dingyiyi0226/Wearable-Torjan-Radar-System/README.md

# Wearable Trojan Radar System

2020 IEEE AP-S Student Design Contest - Team Troy

## How to use

1. Build up the system with the [instruction](Instruction.pdf)

2. Edit the pin setting in `config.py`

3. Run main process

    ```
    python3 main_control.py
    ```

## Links
-  [SDC site](https://2020apsursi.org/StudentDesignContest.asp)
-  [Final report](https://resourcecenter.ieeeaps.org/conferences/2020-ap-symposium/APS2020SYMFIN0160.html)
-  [Demo video](https://youtu.be/o_KWvV_8DFA)
