dingyiyi0226/Wearable-Torjan-Radar-System/layout/5.8GHz Circuits_Bottom (RO4003C 20mil).pdf

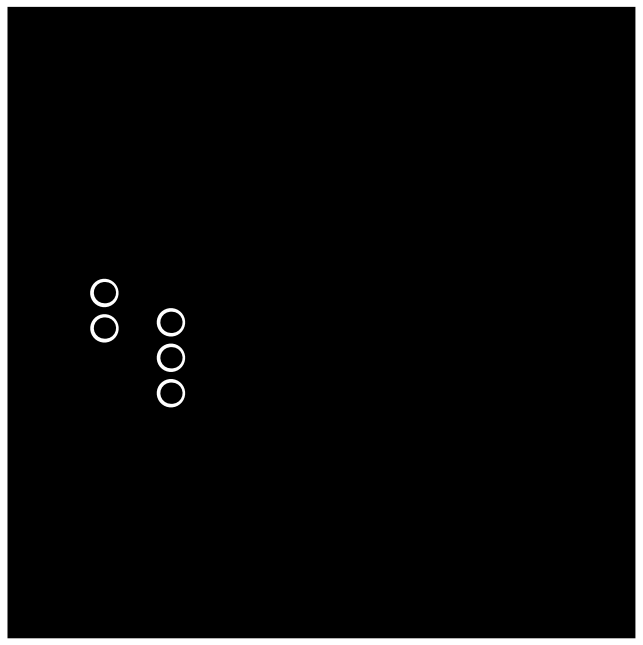
[picture p1: figure]
