dingyiyi0226/Wearable-Torjan-Radar-System/layout/5.8GHz Circuits_Top (RO4003C 20mil).pdf

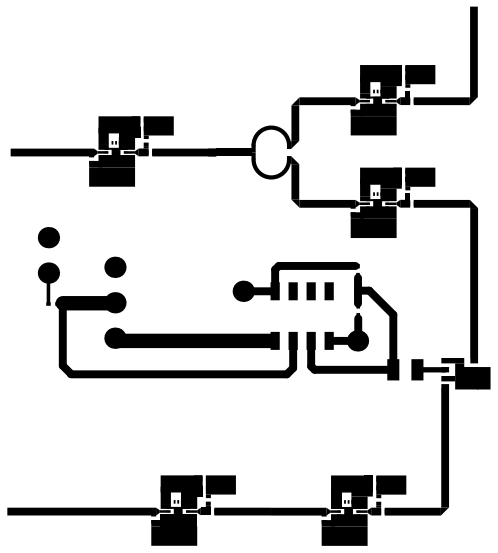
[picture p2: figure]
