dingyiyi0226/Wearable-Torjan-Radar-System/layout/915MHz Circuits_Bottom (RO4003C 20mil).pdf

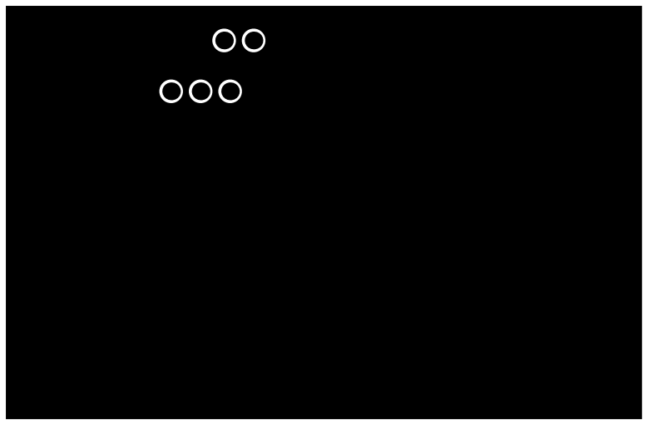
[picture p3: figure]
