dingyiyi0226/Wearable-Torjan-Radar-System/layout/915MHz Circuits_Top (RO4003C 20mil).pdf

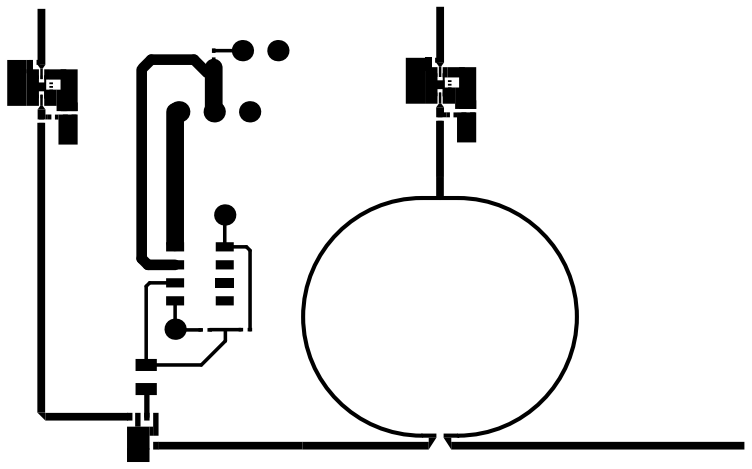
[picture p4: figure]
