dingyiyi0226/Wearable-Torjan-Radar-System/ADC/config.py

# /*****************************************************************************
# * | File        :	  EPD_1in54.py
# * | Author      :   Waveshare team
# * | Function    :   Hardware underlying interface
# * | Info        :
# *----------------
# * |	This version:   V1.0
# * | Date        :   2019-01-24
# * | Info        :   
# ******************************************************************************/
# Permission is hereby granted, free of charge, to any person obtaining a copy
# of this software and associated documnetation files (the "Software"), to deal
# in the Software without restriction, including without limitation the rights
# to use, copy, modify, merge, publish, distribute, sublicense, and/or sell
# copies of the Software, and to permit persons to  whom the Software is
# furished to do so, subject to the following conditions:
#
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


import spidev
import RPi.GPIO as GPIO
import time

# ----------------------------------------------------- #
# Pin declaration (BCM / BOARD)                         # 
# ===================================================== #
# RST_PIN     = 18 / 12                                 #
# CS_PIN      = 22 / 15                                 #
# CS_DAC_PIN  = 23 / 16                                 #
# DRDY_PIN    = 17 / 11                                 #
# ----------------------------------------------------- #

RST_PIN     = 5
CS_PIN      = 7
DRDY_PIN    = 3
# CS_DAC_PIN  = 16

# SPI device, bus = 0, device = 0
SPI = spidev.SpiDev(0, 0)

def digital_write(pin, value):
    GPIO.output(pin, value)

def digital_read(pin):
    return GPIO.input(DRDY_PIN)

def delay_ms(delaytime):
    time.sleep(delaytime // 1000.0)

def spi_writebyte(data):
    SPI.writebytes(data)
    
def spi_readbytes(reg):
    return SPI.readbytes(reg)

def module_init():
    GPIO.setmode(GPIO.BOARD)
    GPIO.setwarnings(False)

    GPIO.setup(RST_PIN, GPIO.OUT)
    # GPIO.setup(CS_DAC_PIN, GPIO.OUT)
    GPIO.setup(CS_PIN, GPIO.OUT)
    GPIO.setup(DRDY_PIN, GPIO.IN, pull_up_down=GPIO.PUD_UP)
    
    SPI.max_speed_hz = 3840000
    SPI.mode = 0b01

    return 0

### END OF FILE ###
