dingyiyi0226/Wearable-Torjan-Radar-System/sigGen/src/main/main.cpp

/*
 * SPI testing utility (using spidev driver)
 *
 * Copyright (c) 2007  MontaVista Software, Inc.
 * Copyright (c) 2007  Anton Vorontsov <avorontsov@ru.mvista.com>
 *
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
 * Cross-compile with cross-gcc -I/path/to/cross-kernel/include
 */

#include <stdint.h>
#include <unistd.h>
#include <stdio.h>
#include <stdlib.h>
#include <getopt.h>
#include <fcntl.h>
#include <sys/ioctl.h>
#include <linux/types.h>
#include <linux/spi/spidev.h>

#include <bcm2835.h>
#include "gpio.h"
#include "sysfs.h"

#define POUT 23 /* P1-16 */

#define ARRAY_SIZE(a) (sizeof(a) / sizeof((a)[0]))

static uint8_t tx[5]  = { 0xF0, 0xF0, 0xF0, 0xF0, 0xF0 };
static uint8_t tx2[5] = { 0xCC, 0xCC, 0xCC, 0xCC, 0xCC };
static char tx3[5]    = { 0xF0, 0xF0, 0xF0, 0xF0, 0xF0 };
static char tx4[5]    = { 0xCC, 0xCC, 0xCC, 0xCC, 0xCC };
static uint8_t rx[ARRAY_SIZE(tx)]   = {0, };

static void
Dec2Hex(uint8_t *value, int dec)
{
    // TODO 
}

static void
getControlWord(int freq, int phase)
{
    // TODO
}

static void
Dec2Bin(char* value, int dec)
{
    // TODO
    int count = 0;

    for (int c = 31; c > 0; --c)
    {
        *(value + count) = ((dec >> c) & 1)? 1 + '0': 0 + '0';
        ++count;
    }

    *(value + count) = 0 + '\0';
}

int
main(int argc, char **argv)
{
    // Setup SPI pins
    if (!bcm2835_init() || !bcm2835_spi_begin())
    {
        printf("BCM2835 SPI Begin failure, please try with sudo\n");
        return EXIT_SUCCESS;
    }

    // Set SPI MSB First
    bcm2835_spi_setBitOrder(BCM2835_SPI_BIT_ORDER_MSBFIRST);

    // Set CHIP (CS0 (19, 21, 23) or CS1)
    bcm2835_spi_chipSelect(BCM2835_SPI_CS0);

    // Set CS pins polarity to low
    bcm2835_spi_setChipSelectPolarity(BCM2835_SPI_CS0, 0);
    bcm2835_spi_setChipSelectPolarity(BCM2835_SPI_CS1, 0);
    
    // Set SPI clock speed 
    // Notes: In RPi2, CDIV4 and CDIV2 mode are unstable.
    bcm2835_spi_setClockDivider(BCM2835_SPI_CLOCK_DIVIDER_2);

    // Set SPI data mode
    bcm2835_spi_setDataMode(BCM2835_SPI_MODE0);

    printf("BCM2835 Peri:\n");
    printf("[CLK ]: %#010X - %#010X\n", 
        bcm2835_clk, bcm2835_peri_read(bcm2835_clk));
    printf("[GPIO]: %#010X - %#010X\n",
        bcm2835_gpio, bcm2835_peri_read(bcm2835_gpio));
    printf("[SPI0]:\n");
    printf("  - CS:   %#010X\n", *bcm2835_spi0);
    printf("  - CDIV: %5d\n", *(bcm2835_spi0 + 2));
    printf("[PADS]:\n");
    printf("                   Current  SLEW\n");
    printf("  - GPIO  0 - 27:     %2d      %d\n", 2 * ((*(bcm2835_pads + 11) & 0x7) + 1), (*(bcm2835_pads + 11) & 0x10) >> 4);
    printf("  - GPIO 28 - 45:     %2d      %d\n", 2 * ((*(bcm2835_pads + 12) & 0x7) + 1), (*(bcm2835_pads + 12) & 0x10) >> 4);
    printf("  - GPIO 46 - 53:     %2d      %d\n", 2 * ((*(bcm2835_pads + 13) & 0x7) + 1), (*(bcm2835_pads + 13) & 0x10) >> 4);

    // bcm2835_peri_write(bcm2835_pads + 11, ((*(bcm2835_pads + 11) | BCM2835_PAD_PASSWRD) & (0xFFFFFFF8)) | 0x7);

    while (1)
    {
        bcm2835_spi_writenb(tx3, ARRAY_SIZE(tx3));
        bcm2835_spi_writenb(tx4, ARRAY_SIZE(tx4));
    }

    // Un-setup SPI pins
    bcm2835_spi_end();
    bcm2835_close();

    return EXIT_SUCCESS;
}
