dingyiyi0226/Wearable-Torjan-Radar-System/module/AD7770.py

"""
  Filename      [ AD7770.py ]
  PackageName   [ Radar ]
  Synopsis      [ AD7770 Signal Reader and processing module ]
"""

import argparse
import os
import numpy as np
import pandas as pd
from functools import reduce
from matplotlib import cm
from matplotlib import pyplot as plt
from matplotlib.image import NonUniformImage
from scipy.signal import correlate, stft
from scipy.constants import c, pi
from scipy.fftpack import fft, fft2, fftshift

def floor(x, step):
    return int(np.floor(x / step) * step)

def listdir(dirname):
    return sorted([os.path.join(dirname, fname) for fname in os.listdir(dirname)])

def readFile(fname, ratio=1e6, removeDC=True, **kwargs):
    df = pd.read_csv(fname, header=None, low_memory=False).loc[:, 1:8]
    df = df[df.notnull().all(axis=1)].to_numpy().transpose() / ratio

    if removeDC:
        df = df - np.mean(df, axis=1)[:, None]

    return df

def readBatchFiles(folder):
    fnames = [fname for fname in listdir(folder) if (os.path.splitext(fname)[0] == '.csv') ]
    print(fnames)

    return

def loadBG(fnames, fs, t_window, t_stride, *args, **kwargs):
    """
    Parameters
    ----------
    fnames : {None, list}

    fs : float

    t_window : float

    t_stride : float

    Return
    ------
    dopplerMap : np.array

    spectrumAVG : np.array
    """

    MODULE_TIME   = kwargs['tm']
    BANDWIDTH     = kwargs['bw']
    CENTER_FREQ   = kwargs['fc']
    MODULE_POINTS = int(MODULE_TIME * fs)

    waveform      = np.zeros(int(data.size))
    spectrumAVG   = np.zeros(int(data.size / 2))
    dopplerAVG    = np.zeros((data.size // MODULE_POINTS, MODULE_POINTS), dtype=np.float64)

    count = 0
    for fname in fnames:
        data = readFile(fname)[0]
        data = data[:floor(data.size, MODULE_POINTS)]

        for start in range(0, data.size - WINDOW_POINT, STRIDE_POINT):
            spectrum = fftshift(np.abs(fft(data[start:start + WINDOW_POINT])))
            spectrum = spectrum[int(data.size / 2):]
            doppler, _, _ = dopplerMap(data.reshape(-1, MODULE_POINTS), BANDWIDTH, CENTER_FREQ, MODULE_TIME)

            spectrumAVG += spectrum
            dopplerAVG  += doppler

            count += 1

    spectrumAVG /= count
    dopplerAVG /= count

    return dopplerMap, spectrumAVG

def dopplerMap(m, bw, fc, tm):
    distance    = c / (2 * bw) * np.arange(-m.shape[1] / 2, m.shape[1] / 2)
    velocity    = c / (2 * fc) / (m.shape[0] * tm) * np.arange(-m.shape[0] / 2, m.shape[0] / 2)
    dopplerMap  = np.abs(fftshift(fft2(m), axes=None)) / m.size
    dopplerMap  = np.clip(dopplerMap, a_min=None, a_max=0.1 * np.max(dopplerMap)) 

    return dopplerMap, distance, velocity

def singleFreqInference(signal, fc, sampleFreq, threshold, segments, stride):
    SEGMENT_POINTS = int(segments * sampleFreq)
    STRIDE_POINTS  = int(stride * sampleFreq)

    f, t, spectrogram = stft(signal, fs=sampleFreq, nperseg=SEGMENT_POINTS, noverlap=STRIDE_POINTS)
    freqIndex = np.argmax(spectrogram, axis=0)
    speed = f[freqIndex] * c / (2 * fc)
    
    return speed

def visualize(fname, visualMethod, fs, t_window, t_stride, drop_last=True, *args, **kwargs):
    """
    Parameters
    ----------
    fname : str

    method : function
        
    fs : float
        sampling frequency

    t_window : float
        observed time

    t_stride : float
        sliding length of time
    """

    # CONSTANTS
    WINDOW_POINT = int(t_window * fs)
    STRIDE_POINT = int(t_stride * fs)

    data = readFile(fname)[1]

    fig, axs = plt.subplots(nrows=3, ncols=1, figsize=(12.8, 7.2))

    for start in range(0, data.size - WINDOW_POINT, STRIDE_POINT):
        # Canvas and drawing method
        for ax in axs: ax.clear()
        segment = data[start: start + WINDOW_POINT]
        visualMethod(segment, fs, axs, **kwargs)

        # Decoration
        fig.suptitle("{}: {} - {}".format(fname, start / fs, (start + WINDOW_POINT) / fs))
        axs[2].semilogy()        

        # Replay setting
        plt.pause(0.1)

    # plt.show()
    plt.close()

    return

def singleFrequency(data, fs, axs, *args, **kwargs):
    """
    Parameters
    ----------
    data : np.array

    fs : float
        sampling frequency

    t_window : float
        observed time

    t_stride : float
        sliding length of time
    """
    # Constant
    CENTER_FREQ = kwargs['fc']

    spectrum = np.abs(fftshift(fft(data))) / data.size
    spectrum = spectrum[int(data.size / 2):]
    freqAxis = np.linspace(0, fs / 2, spectrum.shape[0], endpoint=False)
    timeAxis = np.linspace(0, data.shape[0] / fs, data.shape[0], endpoint=False)    
    maxIndex = np.argmax(spectrum)

    # Time Axis
    ax = axs[1]
    ax.plot(timeAxis, data)
    ax.set_title('Waveform')

    # Frequency Axis
    ax = axs[2]
    ax.plot(freqAxis, spectrum)
    ax.annotate("{:.2f}".format(freqAxis[maxIndex] * c / (2 * CENTER_FREQ)), (freqAxis[maxIndex], np.max(spectrum)))
    ax.set_title('Frequency')

    return

def singleModulation(data, fs, axs, *args, **kwargs):
    """
    Parameters
    ----------
    data : np.array

    fs : float
        sampling frequency

    t_window : float
        observed time

    t_stride : float
        sliding length of time
    """

    # Constant
    MODULE_TIME   = kwargs['tm']
    BANDWIDTH     = kwargs['bw']
    CENTER_FREQ   = kwargs['fc']

    MODULE_POINTS = int(MODULE_TIME * fs)

    # Data Pre-Processing
    data = data[:floor(data.size, MODULE_POINTS)]

    # Data Processing
    spectrum = np.abs(fftshift(fft(data)))
    spectrum = spectrum[int(data.size / 2):]
    doppler, distance, velocity = dopplerMap(data.reshape(-1, MODULE_POINTS), BANDWIDTH, CENTER_FREQ, MODULE_TIME)

    timeAxis = np.linspace(0, data.shape[0] / fs, data.shape[0], endpoint=False)
    freqAxis = np.linspace(0, fs / 2, spectrum.shape[0], endpoint=False)
    maxIndex = np.argmax(spectrum)

    # Doppler Map
    ax = axs[0]
    img = NonUniformImage(ax, cmap=cm.Purples)
    img.set_data(distance, velocity, doppler)
    ax.images.append(img)
    ax.set_xlim(np.min(distance), np.max(distance))
    ax.set_ylim(np.min(velocity), np.max(velocity))
    ax.set_title('Doppler Map')

    # Time Axis
    ax = axs[1]
    ax.plot(timeAxis, data)
    ax.set_title('Waveform')

    # Frequency Axis
    ax = axs[2]
    ax.plot(freqAxis, spectrum)
    ax.annotate("{:.2f}".format(freqAxis[maxIndex]), (freqAxis[maxIndex], np.max(spectrum)))
    ax.set_title('Frequency')

    return

def main():
    parser = argparse.ArgumentParser()
    parser.add_argument('-d', '--dir', help="Directory of the records.")
    parser.add_argument('-r', '--removeBG', nargs='*', help="Remove background if background file is specified.")
    parser.add_argument('-c', '--channel', type=int, default=1, help="Read from selected AD7770 Channel")
    parser.add_argument('--bandwidth', type=float, default=1e8, help="Bandwidth of the Radar")
    parser.add_argument('--centerFreq', type=float, default=5.8e9, help="Center frequency of the Radar")
    parser.add_argument('--moduleTime', type=float, default=[4e-3], nargs='*', help="Interval of Frequency Modulation.")
    parser.add_argument('--compressor', default=1.0, type=float, help="Help visualizing doppler map if lower than 1.0")
    parser.add_argument('--repeat', action='store_true', help="Repeat until KeyboardInterrupt if set true.")
    parser.add_argument('--stride', default=0.125, type=float, help="Specified sliding length of each step")
    parser.add_argument('--window', default=0.25, type=float, help="Specified window length in second.")
    args = parser.parse_args()

    # CONSTANT
    SAMPLE_FREQ = 1.6e4
    SAMPLE_TIME = 1 / SAMPLE_FREQ

    BANDWIDTH    = args.bandwidth
    CENTER_FREQ  = args.centerFreq
    MODULE_TIME  = args.moduleTime[0]    
    SEGMENT_TIME = args.window
    STRIDE_TIME  = args.stride

    # Selecting Background
    if isinstance(args.removeBG, list):
        args.removeBG = [os.path.join(args.dir, fname) for fname in args.removeBG]

        fig, axs = plt.subplots(nrows=len(args.removeBG) + 1, ncols=3, figsize=(19.2, 10.8))
        timeAxis = np.arange(0, int(args.window * SAMPLE_FREQ)) / SAMPLE_FREQ
        freqAxis = np.linspace(-SAMPLE_FREQ / 2, SAMPLE_FREQ / 2, int(args.window * SAMPLE_FREQ), endpoint=False)
        spectrums = np.zeros((len(args.removeBG), int(args.window * SAMPLE_FREQ)))

        for index, fname in enumerate(args.removeBG):
            data = readFile(fname)[args.channel, :int(args.window * SAMPLE_FREQ)]
            spectrumBG = np.abs(fftshift(fft(data))) / data.size
            spectrums[index] = spectrumBG
            axs[index, 0].plot(timeAxis, data)
            axs[index, 1].plot(freqAxis, spectrumBG)
            axs[index, 1].set_xlim(0, np.max(freqAxis))
            axs[index, 1].semilogy()
            axs[index, 0].set_title('Waveform: {}'.format(fname))
            axs[index, 1].set_title('Spectrum: {}'.format(fname))

        for index, fname in enumerate(args.removeBG):
            axs[index, 2].plot(freqAxis, np.log(spectrums[index]) - np.log(np.mean(spectrums, axis=0)))
            axs[index, 2].semilogy()
            axs[index, 2].set_xlim(0, np.max(freqAxis))
            axs[index, 2].set_title('Reject BG: {}'.format(fname))

        data = readFile(os.path.join(args.dir, '200101.csv'))[1, :int(args.window * SAMPLE_FREQ)]
        axs[len(args.removeBG), 0].plot(timeAxis, data)
        axs[len(args.removeBG), 1].plot(freqAxis, np.abs(fftshift(fft(data))) / data.size)
        axs[len(args.removeBG), 2].plot(freqAxis, np.abs(fftshift(fft(data))) / data.size - np.mean(spectrums, axis=0))        
        axs[len(args.removeBG), 1].semilogy()
        axs[len(args.removeBG), 2].semilogy()
        axs[len(args.removeBG), 2].set_xlim(0, np.max(freqAxis))

        plt.savefig('bg.png')

    # raise

    # -------------------------------------------------------- # 
    # Experiment 0512                                          #
    # -------------------------------------------------------- #

    filenames = [fname for fname in listdir('./rawdata/0512_sawtooth_4ms') if os.path.basename(fname).endswith('1.csv')]
    for fname in filenames:
        visualize(fname, singleModulation, SAMPLE_FREQ, SEGMENT_TIME, STRIDE_TIME, fc=CENTER_FREQ, bw=BANDWIDTH, tm=MODULE_TIME)

    # MODULE_TIME = 8e-3
    # filenames = [fname for fname in listdir('./rawdata/0512_sawtooth_8ms') if os.path.basename(fname).endswith('1.csv')]
    # for fname in filenames:
    #     visualize(fname, sawtooth, SAMPLE_FREQ, SEGMENT_TIME, STRIDE_TIME, fc=CENTER_FREQ, bw=BANDWIDTH, tm=MODULE_TIME)

    # MODULE_TIME = 16e-3
    # filenames = [fname for fname in listdir('./rawdata/0512_sawtooth_16ms') if os.path.basename(fname).endswith('1.csv')]
    # for fname in filenames:
    #     visualize(fname, sawtooth, SAMPLE_FREQ, SEGMENT_TIME, STRIDE_TIME, fc=CENTER_FREQ, bw=BANDWIDTH, tm=MODULE_TIME)

    # -------------------------------------------------------- # 
    # Experiment 0514                                          #
    # -------------------------------------------------------- #



    return

if __name__ == "__main__":
    main()
