dingyiyi0226/Wearable-Torjan-Radar-System/ADC/main.py

#!/usr/bin/python
# -*- coding:utf-8 -*-

import argparse
import os
import time
from threading import Thread

import numpy as np
from matplotlib import pyplot as plt
from scipy.fftpack import fft, fftshift

import ADS1256
# import ADS1256_2 
# import DAC8532
import RPi.GPIO as GPIO

# os.nice(20)

parser = argparse.ArgumentParser("High Precision Anolog / Digital Converter")
parser.add_argument("-n", "--number", default=4000, type=int, help="Number of data points.")
parser.add_argument("--accept", default=1.6e4, type=float, help="Threshold to accept the sampling")
parser.add_argument("-c", "--channel", default=0, type=int, help="Serial port number.")
args = parser.parse_args()

def readThread(name, adc):
    while True:
        buf, fs = adc.Read_ADC_Data_Continuous()
        print("Thread {}".format(fs), end="")

    return

def main():
    fig, ax = plt.subplots(nrows=2, ncols=1)

    ADC = ADS1256.ADS1256()
    ADC.init()
    ADC.SetChannal(args.channel)
    ADC._writeCmd(ADS1256.CMD['CMD_SYNC'])
    ADC._writeCmd(ADS1256.CMD['CMD_WAKEUP'])
    ADC.Start_Read_ADC_Data_Continuous()

    # ADC2 = ADS1256_2.ADS1256()
    # ADC2.init()
    # ADC2.SetChannal(args.channel)
    # ADC2.WriteCmd(ADS1256.CMD['CMD_SYNC'])
    # ADC2.WriteCmd(ADS1256.CMD['CMD_WAKEUP'])
    # ADC2.Start_Read_ADC_Data_Continuous()

    try:
        while True:
            # Load data points
            buf, fs = ADC.Read_ADC_Data_Continuous(args.number)
            timedelta = args.number / fs 
            print("\r{}".format(fs), end="")
    
            if (fs > args.accept):
                buf /= (10 ** 6)

                # Time Axis
                ax[0].clear()
                ax[0].plot(
                    np.linspace(0, timedelta, args.number), 
                    buf
                )

                # Frequency Axis
                ax[1].clear()
                ax[1].plot(
                    np.linspace(-fs / 2, fs / 2, args.number, endpoint=False), 
                    np.abs(fftshift(fft(buf))) / args.number
                )

                # Show figure
                plt.pause(0.01)
    
    except Exception as e:
        print(e)
        GPIO.cleanup()
        exit()
   
    # threads = [
    #     Thread(target=readThread, args=(idx, adc), daemon=True) for (idx, adc) in ((1, ADC), (2, ADC2))
    # ]

    # for thread in threads:
    #     thread.start()


if __name__ == "__main__":
    main()
