dingyiyi0226/Wearable-Torjan-Radar-System/config.py

ADF_HIGH_PINS = {
    # 'GND': 14,       # T3
    'W_CLK': 8,        # T4
    'DATA' : 10,       # T5
    'LE'   : 12,       # T6
    'TXDATA' : 16,     # T16
    'MUXOUT' : 18,     # T8
}

ADF_LOW_PINS = {
    # 'GND': 9,        # T3
    'W_CLK': 11,       # T4
    'DATA' : 13,       # T5
    'LE'   : 15,       # T6
    'TXDATA' : 5,      # T16
    'MUXOUT' : 7,      # T8
}

DIR_PINS = {
    'STEP': 31,
    'DIR' : 33,
    'ENA' : 40,          # no use
}
