dingyiyi0226/Wearable-Torjan-Radar-System/(commit log)

2019-11-21 simple control between python and arduino
    [phase.csv]
2019-11-22 add velo and range info
    [phase.csv]
2019-11-27 remove phase related part
    [phase.csv]
2020-01-28 add sim version and fix plotting
    [main_control.py]
2020-02-24 add plotting heatmap
2020-02-24 plotSingleFile add filter
2020-02-25 Add readcsv.py path issue
    [main.py]
2020-02-28 fix readSimSignal and RadarView
    [main_control.py]
2020-03-06 add velocity in plotTheo
2020-03-06 add velo in heatmap
2020-03-16 fix heatmap ylimit
2020-03-18 Optimize Main and Arduino code
2020-04-09 Added motor controller
2020-05-19 Renamed AD-DA-Board
2020-05-26 Modify ADC Module
2020-05-27 Modify ADC
2020-06-03 Added ADC
2020-06-04 add resetdir, fix signalreceiver
    [A4988.py, main_control.py]
