dingyiyi0226/Wearable-Torjan-Radar-System/(notices)

Notices in the files:
sigGen/src/main/main.cpp:
This program is free software; you can redistribute it and/or modify
it under the terms of the GNU General Public License as published by
the Free Software Foundation; either version 2 of the License.
